shimotoriharuki/2024_robotracer/2024_robotracer_control_design/servo_gain.txt

-30.8843942783021,-3.27677844337711,-0.201098294451269,-0.307268950808485
