shimotoriharuki/2024_robotracer/2024_robotracer_circuit/main/main.dxf

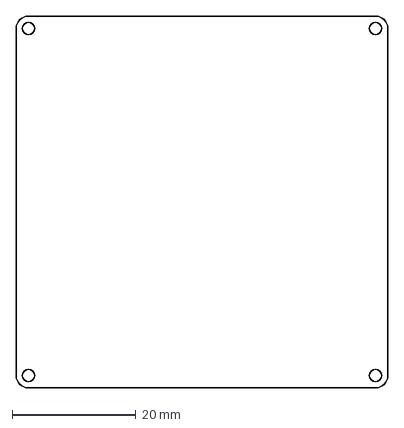
[picture p1: CAD file, 2024-09-07]
2024_robotracer_circuit/main/main.dxf
60.0 x 60.0 mm
