shimotoriharuki/2024_robotracer/2024_robotracer_circuit/following_sensor/following_sensor.step

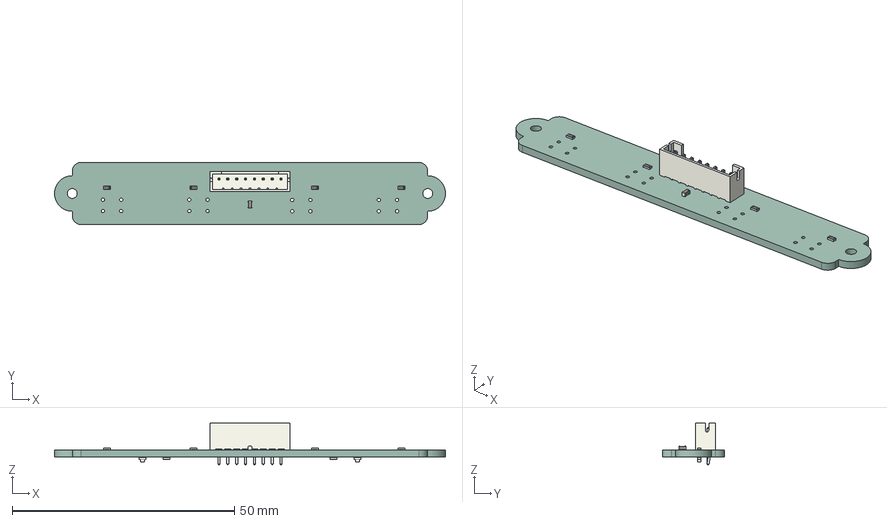
[picture p2: CAD file, 2024-07-03]
2024_robotracer_circuit/following_sensor/following_sensor.step
88.0 x 14.0 x 9.40 mm
C_0603_1608Metric
R_0603_1608Metric x 6
JST_B8B_PH_K
LED_0603_1608Metric x 2
following_sensor_PCB
