shimotoriharuki/2024_robotracer/2024_robotracer_circuit/sd_card/sd_card.step

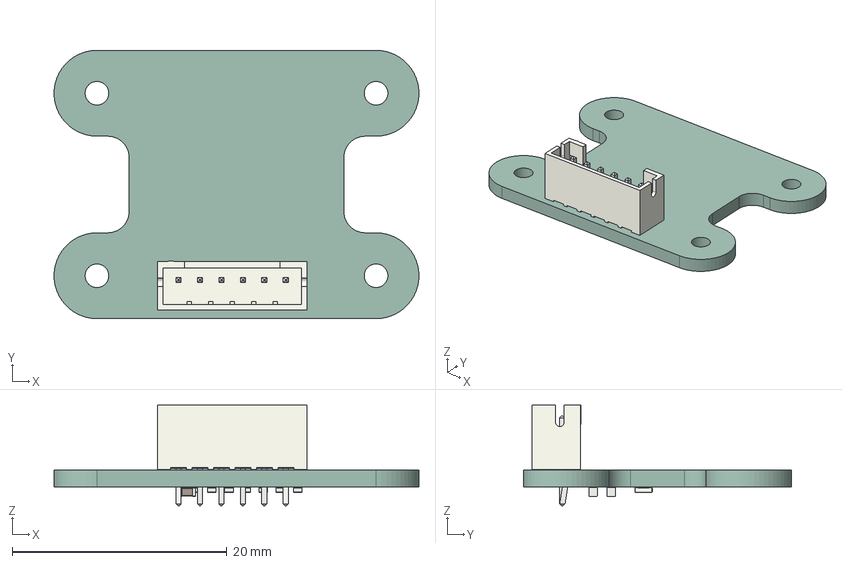
[picture p3: CAD file, 2024-07-03]
2024_robotracer_circuit/sd_card/sd_card.step
34.0 x 25.0 x 9.40 mm
JST_B6B_PH_K
R_0603_1608Metric x 7
C_0603_1608Metric x 2
sd_card_PCB
