shimotoriharuki/2024_robotracer/2024_robotracer_circuit/side_sensor/side_sensor.step

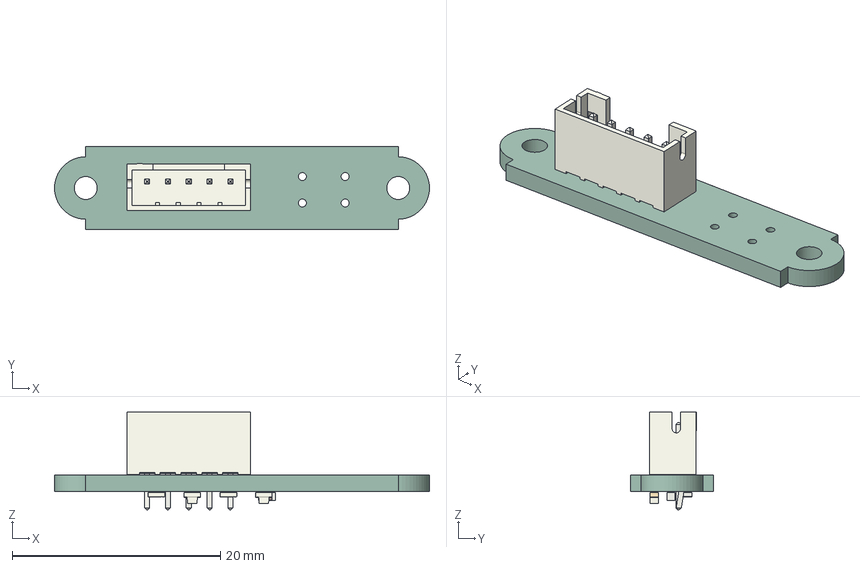
[picture p4: CAD file, 2024-07-03]
2024_robotracer_circuit/side_sensor/side_sensor.step
36.0 x 8.00 x 9.40 mm
JST_B5B_PH_K
R_0603_1608Metric x 3
C_0603_1608Metric
LED_0603_1608Metric x 2
side_sensor_PCB
