shimotoriharuki/2024_robotracer/2024_robotracer_mecha/3d_print_data/chassis2 v21.3mf

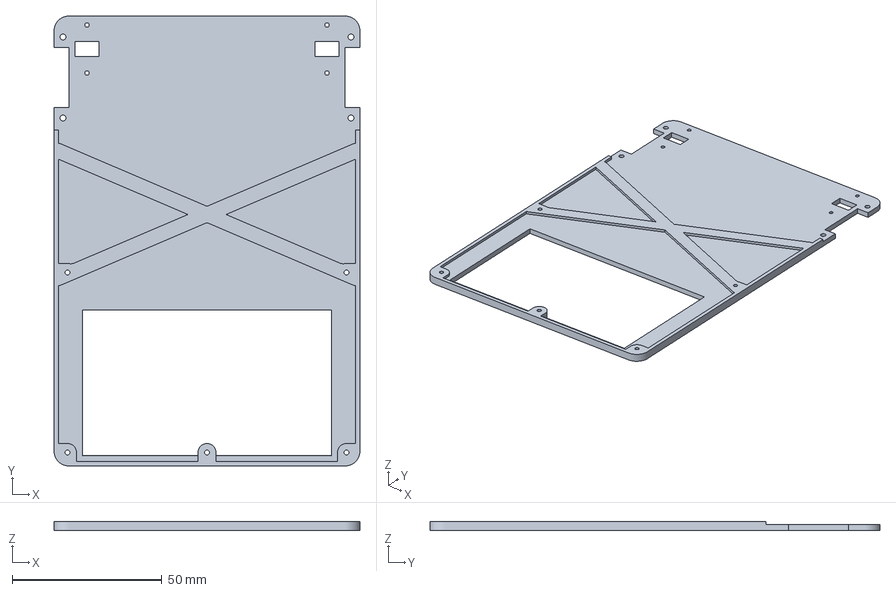
[picture p5: CAD file, 2024-07-13]
2024_robotracer_mecha/3d_print_data/chassis2 v21.3mf
102.0 x 150.0 x 3.00 mm
