shimotoriharuki/2024_robotracer/2024_robotracer_mecha/motor_mount v37.step

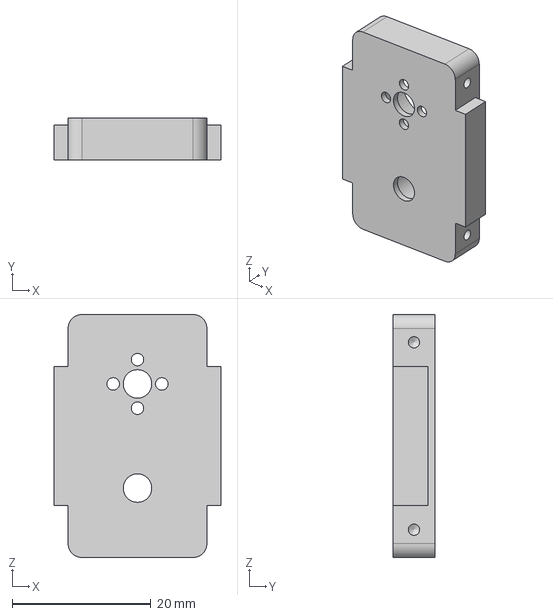
[picture p6: CAD file, 2024-09-07]
2024_robotracer_mecha/motor_mount v37.step
24.0 x 6.00 x 35.0 mm
