shimotoriharuki/2024_robotracer/2024_robotracer_mecha/3d_print_data/sensor_cover v4.3mf

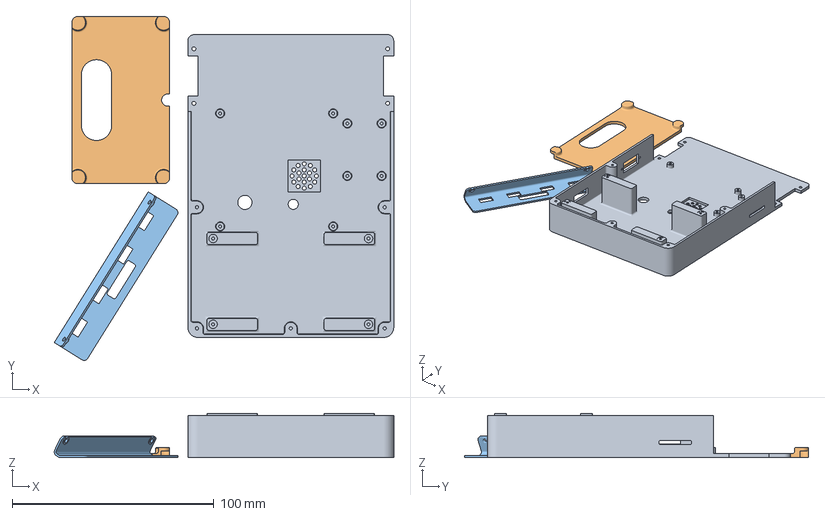
[picture p7: CAD file, 2024-07-13]
2024_robotracer_mecha/3d_print_data/sensor_cover v4.3mf
168.2 x 170.4 x 22.0 mm
chassis v33.step
battery_cover v20.step
sensor_cover v4.step
