shimotoriharuki/2024_robotracer/2024_robotracer_mecha/sensor_mount2 v6(ミラー).step

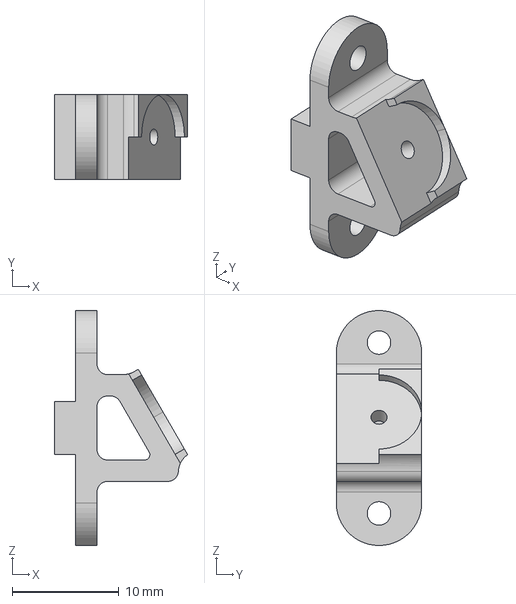
[picture p8: CAD file, 2024-09-07]
2024_robotracer_mecha/sensor_mount2 v6(ミラー).step
12.5 x 8.00 x 22.0 mm
