shimotoriharuki/2024_robotracer/2024_robotracer_mecha/3d_print_data/bearing_spacer v4.3mf

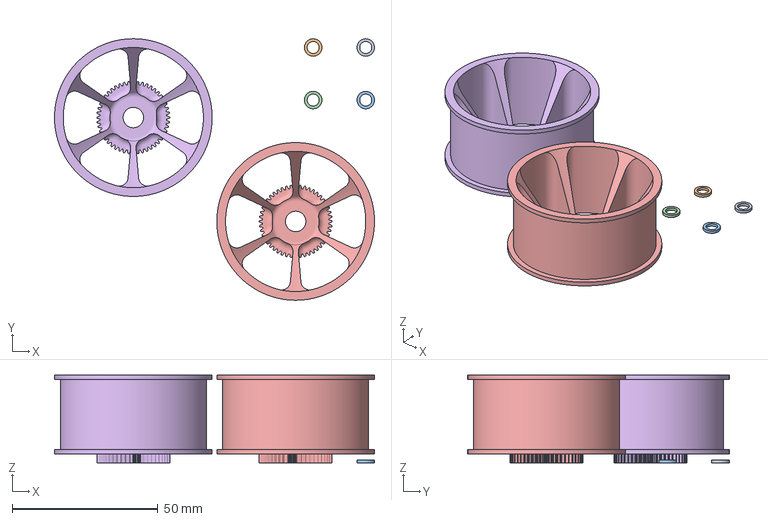
[picture p9: CAD file, 2024-07-13]
2024_robotracer_mecha/3d_print_data/bearing_spacer v4.3mf
109.6 x 89.6 x 30.0 mm
bearing_spacer v4.step x 4
wheel v11.step x 2
