shimotoriharuki/2024_robotracer/2024_robotracer_mecha/battery_cover v20.step

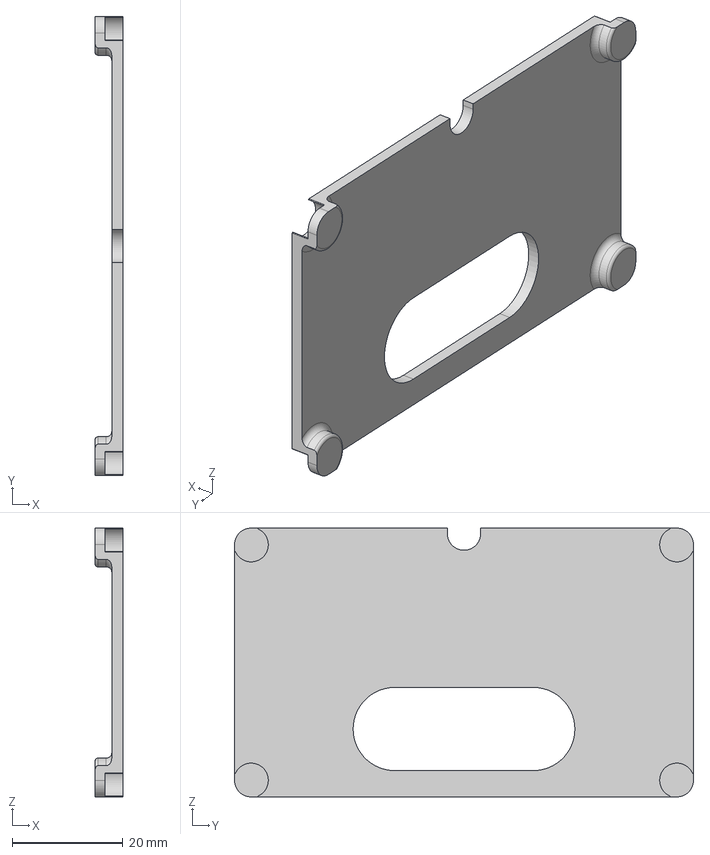
[picture p10: CAD file, 2024-09-07]
2024_robotracer_mecha/battery_cover v20.step
5.00 x 82.8 x 48.5 mm
