shimotoriharuki/2024_robotracer/2024_robotracer_mecha/3d_print_data/motor_mount v30.3mf

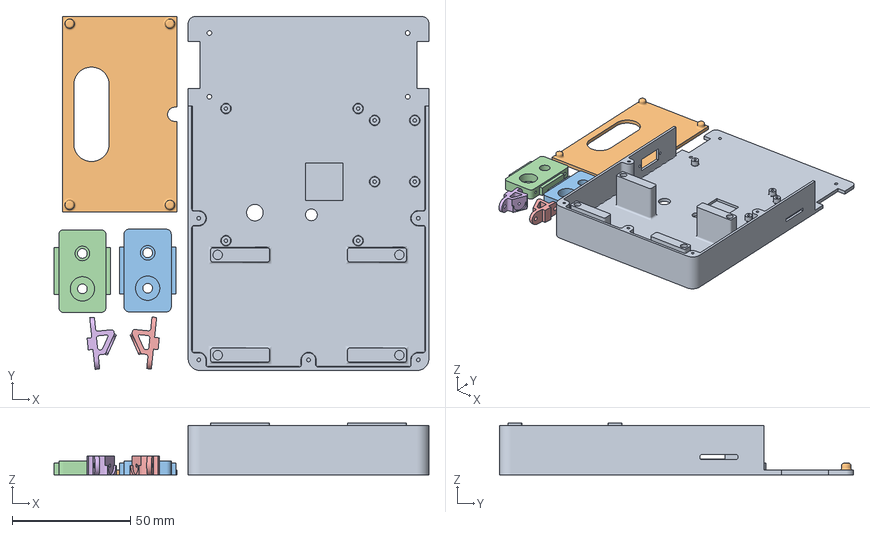
[picture p11: CAD file, 2024-07-13]
2024_robotracer_mecha/3d_print_data/motor_mount v30.3mf
158.8 x 150.0 x 22.0 mm
chassis v31.step
battery_cover v19.step
motor_mount v30.step x 2
sensor_mount2 v6(ミラー).step
sensor_mount2 v8.step
