shimotoriharuki/2024_robotracer/2024_robotracer_mecha/gear_t12_m0.5 v4.step

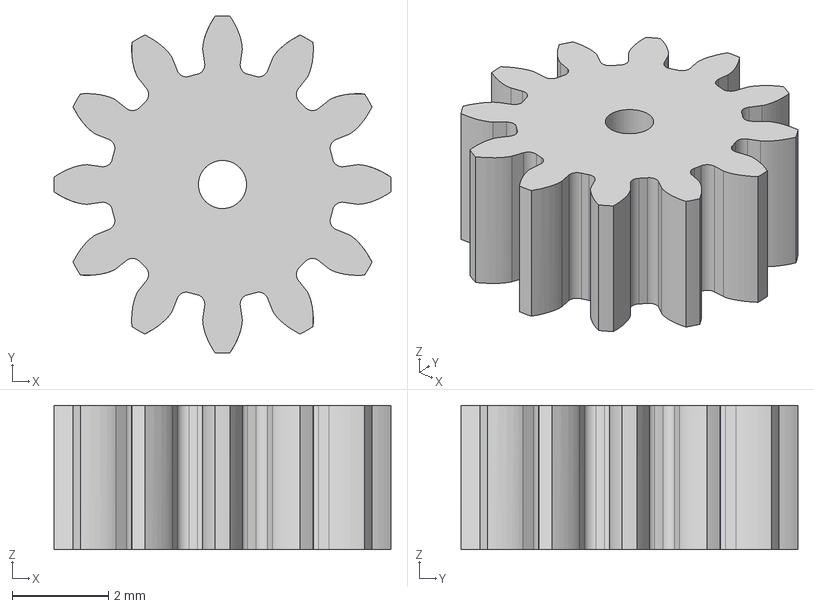
[picture p12: CAD file, 2024-09-07]
2024_robotracer_mecha/gear_t12_m0.5 v4.step
7.00 x 7.00 x 3.00 mm
