shimotoriharuki/2024_robotracer/2024_robotracer_mecha/circuit_spacer v2.step

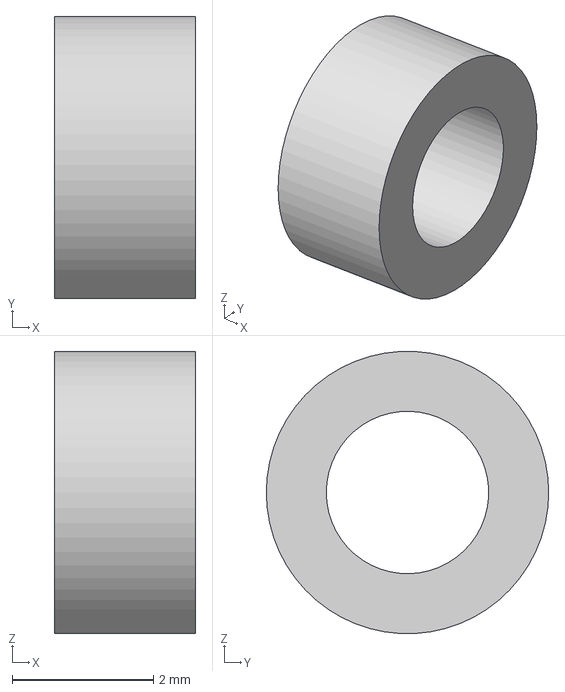
[picture p13: CAD file, 2024-09-07]
2024_robotracer_mecha/circuit_spacer v2.step
2.00 x 4.00 x 3.99 mm
