shimotoriharuki/2024_robotracer/2024_robotracer_mecha/chassis2 v23.step

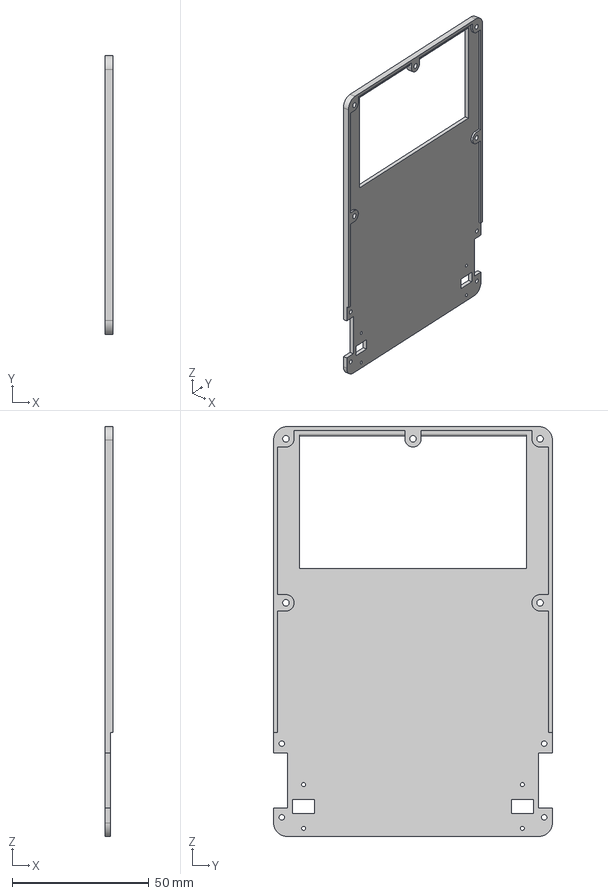
[picture p14: CAD file, 2024-09-07]
2024_robotracer_mecha/chassis2 v23.step
3.00 x 102.0 x 150.0 mm
