shimotoriharuki/2024_robotracer/2024_robotracer_mecha/bearing_spacer v4.step

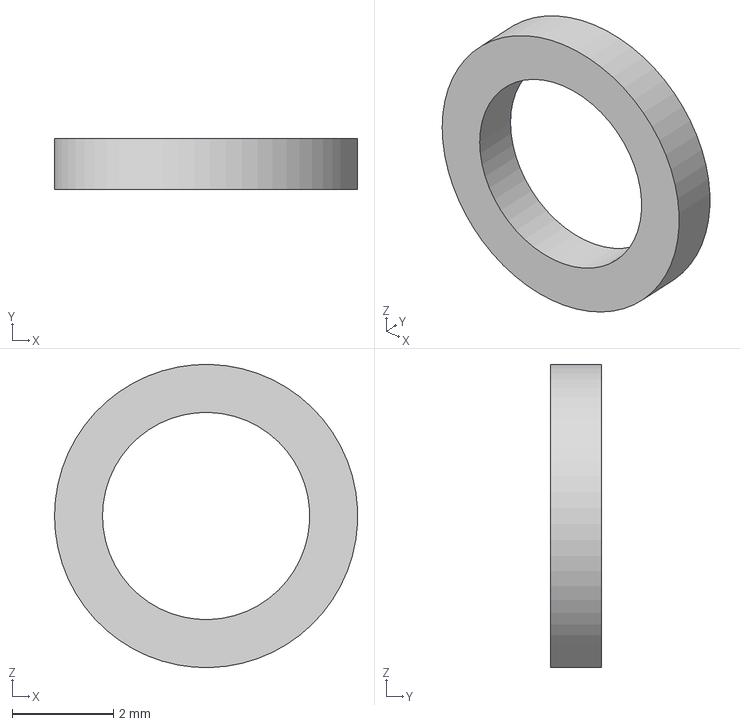
[picture p15: CAD file, 2024-09-07]
2024_robotracer_mecha/bearing_spacer v4.step
6.00 x 1.00 x 6.00 mm
