shimotoriharuki/2024_robotracer/2024_robotracer_mecha/chassis v45.step

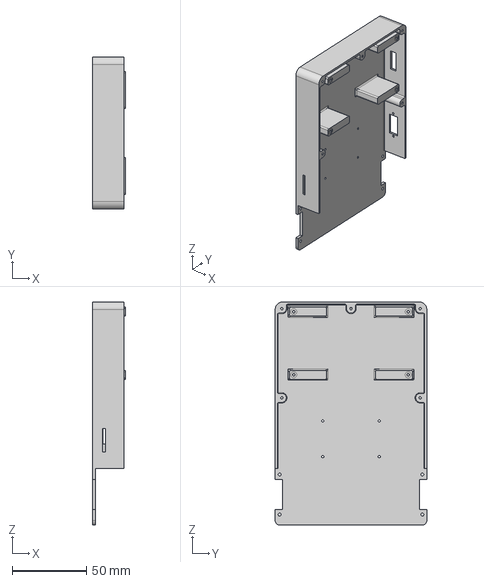
[picture p16: CAD file, 2024-09-07]
2024_robotracer_mecha/chassis v45.step
22.0 x 102.0 x 150.0 mm
