shimotoriharuki/2024_robotracer/2024_robotracer_mecha/sensor_cover v4.step

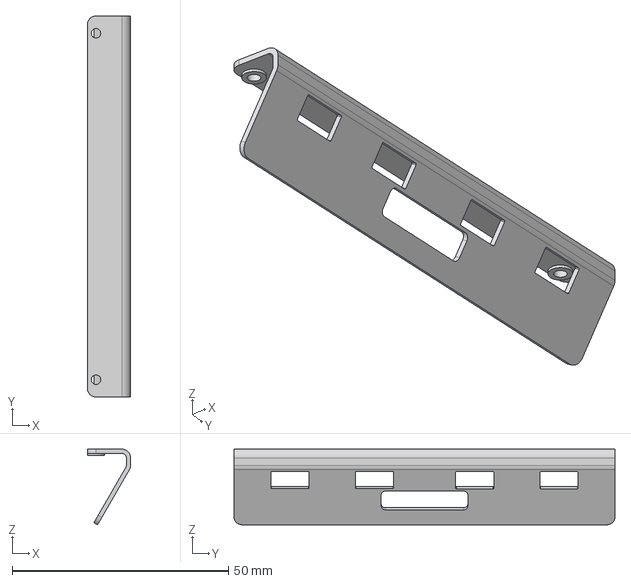
[picture p17: CAD file, 2024-09-07]
2024_robotracer_mecha/sensor_cover v4.step
10.0 x 88.0 x 17.5 mm
