shimotoriharuki/2024_robotracer/(list of files, cad)

Other CAD files:
2024_robotracer_mecha/sensor_mount2 v8.step
