shimotoriharuki/2024_robotracer/2024_robotracer_circuit/side_sensor/side_sensor.kicad_pcb

## KiCad design 2024_robotracer_circuit/side_sensor/side_sensor.kicad_pcb (2024-09-07)

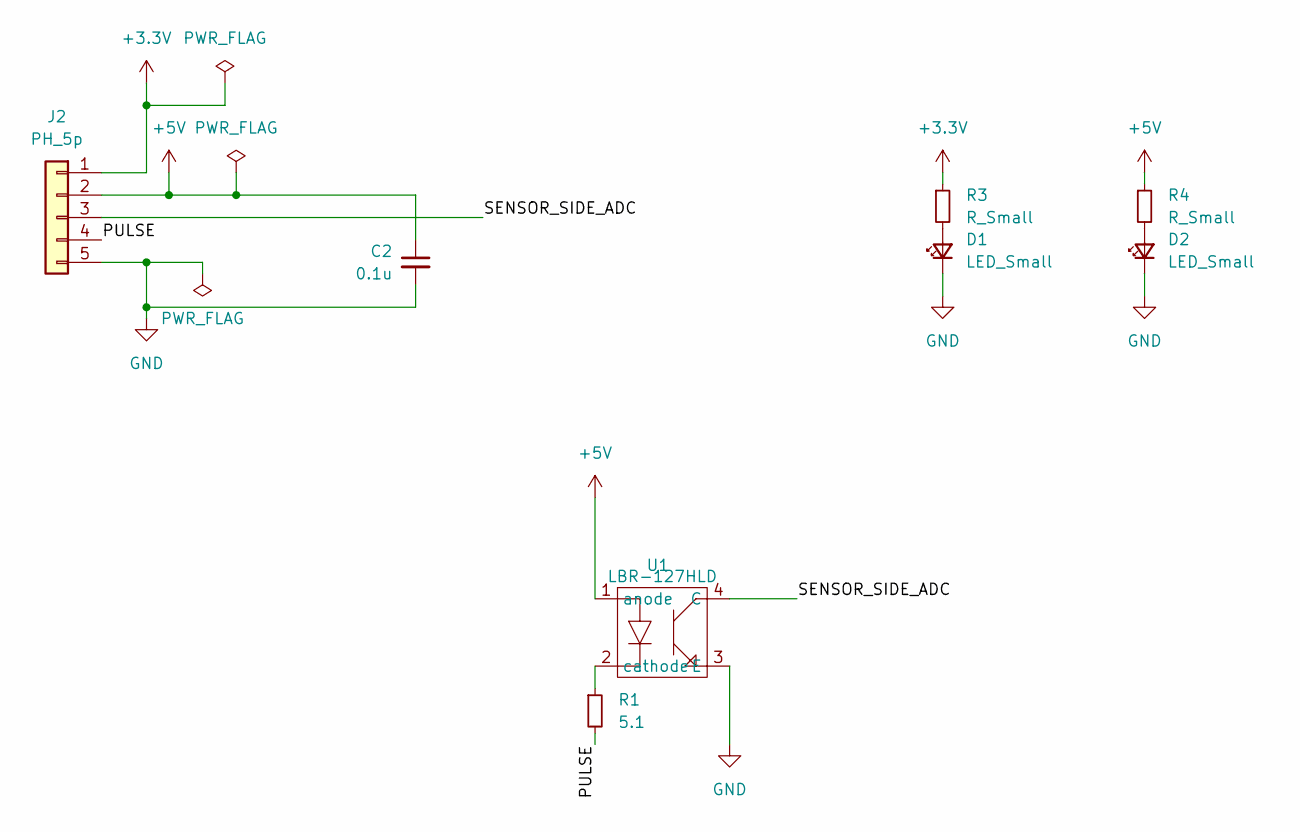
[picture p18: schematic side_sensor.kicad_sch]

Parts:
C2: 0.1u; C_0603_1608Metric_Pad1.08x0.95mm_HandSolder
D1, D2: LED_Small; LED_0603_1608Metric_Pad1.05x0.95mm_HandSolder
J2: PH_5p; JST_PH_B5B-PH-K_1x05_P2.00mm_Vertical
R1: 5.1; R_0603_1608Metric_Pad0.98x0.95mm_HandSolder
R3, R4: R_Small; R_0603_1608Metric_Pad0.98x0.95mm_HandSolder
U1: LBR-127HLD

Connections:
+3.3V: J2.1, R3.1
+5V: C2.1, J2.2, R4.1, U1.1 (anode)
/PULSE: J2.4, R1.2
/SENSOR_SIDE_ADC: J2.3, U1.4 (C)
GND: C2.2, D1.1 (K), D2.1 (K), J2.5, U1.3 (E)
unnamed: D1.2 (A), R3.2
unnamed: D2.2 (A), R4.2
unnamed: R1.1, U1.2 (cathode)

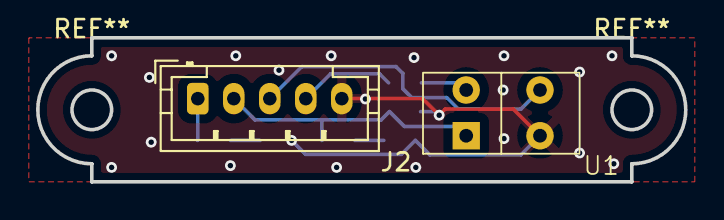
[picture p19: board side_sensor.kicad_pcb from above]

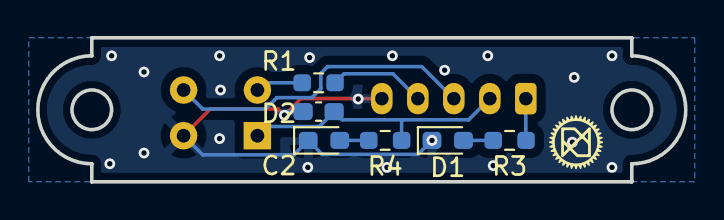
[picture p20: board side_sensor.kicad_pcb from below]

Board: 2 copper layers, 36.0 x 8.0 mm, 8 parts (6 on the bottom side), 8 nets.
