shimotoriharuki/2024_robotracer/2024_robotracer_circuit/following_sensor/following_sensor.kicad_pcb

## KiCad design 2024_robotracer_circuit/following_sensor/following_sensor.kicad_pcb (2024-09-07)

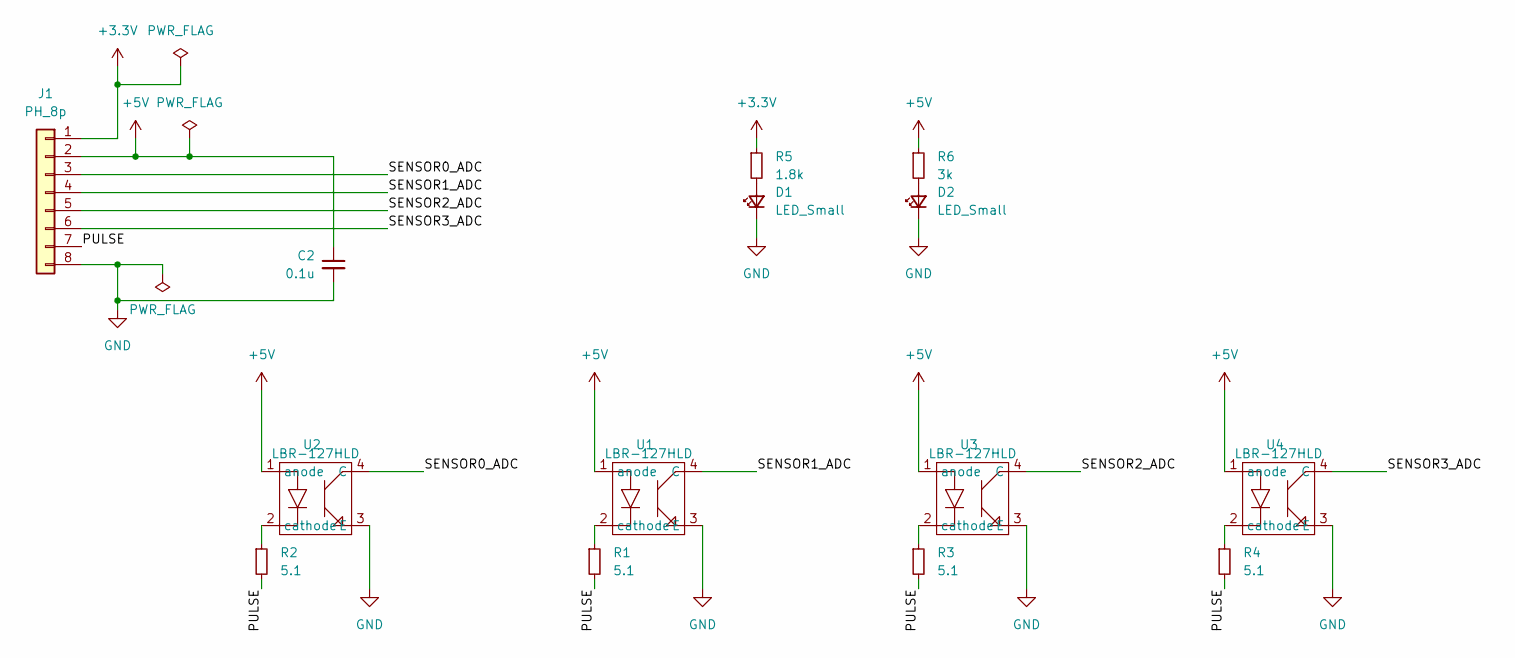
[picture p21: schematic following_sensor.kicad_sch]

Parts:
C2: 0.1u; C_0603_1608Metric_Pad1.08x0.95mm_HandSolder
D1, D2: LED_Small; LED_0603_1608Metric_Pad1.05x0.95mm_HandSolder
J1: PH_8p; JST_PH_B8B-PH-K_1x08_P2.00mm_Vertical
R1, R2, R3, R4: 5.1; R_0603_1608Metric_Pad0.98x0.95mm_HandSolder
R5: 1.8k; R_0603_1608Metric_Pad0.98x0.95mm_HandSolder
R6: 3k; R_0603_1608Metric_Pad0.98x0.95mm_HandSolder
U1, U2, U3, U4: LBR-127HLD

Connections:
+3.3V: J1.1, R5.1
+5V: C2.1, J1.2, R6.1, U1.1 (anode), U2.1 (anode), U3.1 (anode), U4.1 (anode)
/PULSE: J1.7, R1.2, R2.2, R3.2, R4.2
/SENSOR0_ADC: J1.3, U2.4 (C)
/SENSOR1_ADC: J1.4, U1.4 (C)
/SENSOR2_ADC: J1.5, U3.4 (C)
/SENSOR3_ADC: J1.6, U4.4 (C)
GND: C2.2, D1.1 (K), D2.1 (K), J1.8, U1.3 (E), U2.3 (E), U3.3 (E), U4.3 (E)
unnamed: D1.2 (A), R5.2
unnamed: D2.2 (A), R6.2
unnamed: R1.1, U1.2 (cathode)
unnamed: R2.1, U2.2 (cathode)
unnamed: R3.1, U3.2 (cathode)
unnamed: R4.1, U4.2 (cathode)

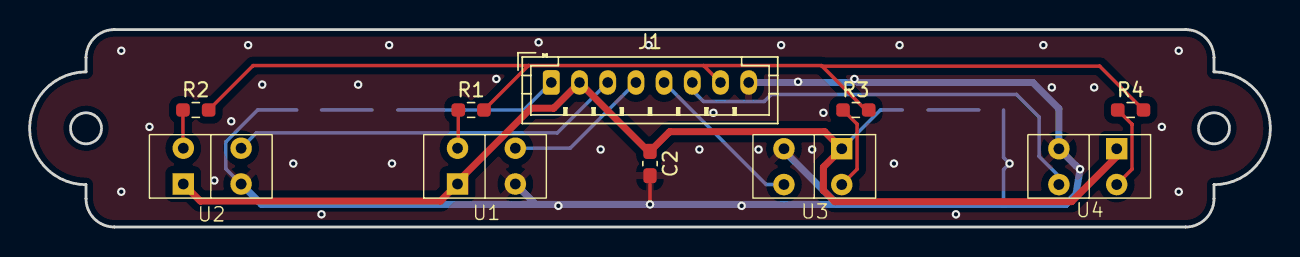
[picture p22: board following_sensor.kicad_pcb from above]

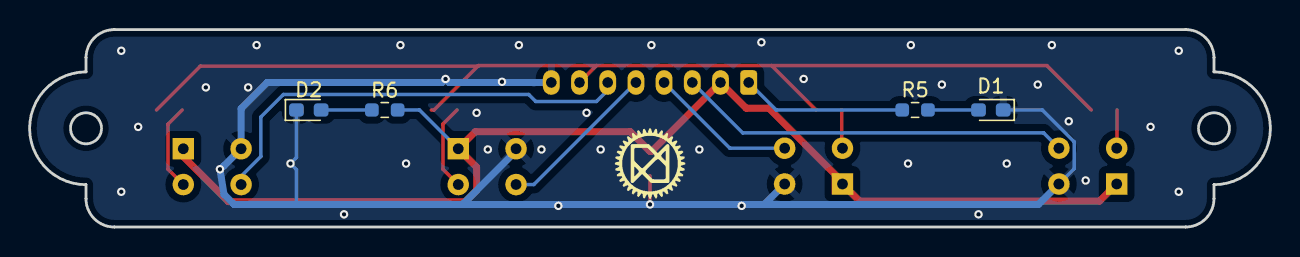
[picture p23: board following_sensor.kicad_pcb from below]

Board: 2 copper layers, 88.0 x 14.0 mm, 14 parts (4 on the bottom side), 14 nets.
