shimotoriharuki/2024_robotracer/2024_robotracer_circuit/sd_card/sd_card.kicad_pcb

## KiCad design 2024_robotracer_circuit/sd_card/sd_card.kicad_pcb (2024-09-07)

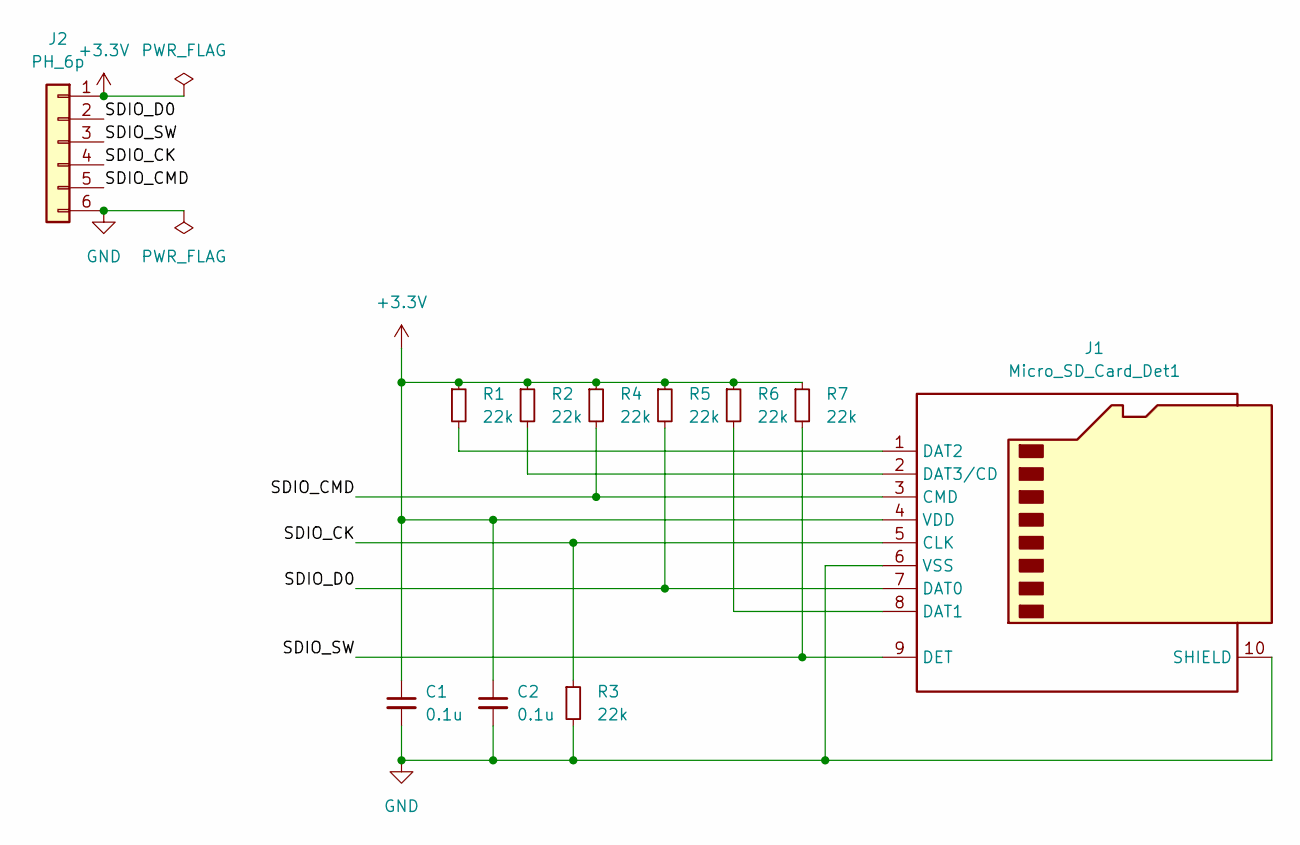
[picture p24: schematic sd_card.kicad_sch]

Parts:
C1, C2: 0.1u; C_0603_1608Metric_Pad1.08x0.95mm_HandSolder
J1: Micro_SD_Card_Det1; microSD_HC_Hirose_DM3AT-SF-PEJM5
J2: PH_6p; JST_PH_B6B-PH-K_1x06_P2.00mm_Vertical
R1, R2, R3, R4, R5, R6, R7: 22k; R_0603_1608Metric_Pad0.98x0.95mm_HandSolder

Connections:
+3.3V: C1.1, C2.1, J1.4 (VDD), J2.1, R1.1, R2.1, R4.1, R5.1, R6.1, R7.1
/SDIO_CK: J1.5 (CLK), J2.4, R3.1
/SDIO_CMD: J1.3 (CMD), J2.5, R4.2
/SDIO_D0: J1.7 (DAT0), J2.2, R5.2
/SDIO_SW: J1.9 (DET), J2.3, R7.2
GND: C1.2, C2.2, J1.6 (VSS), J1.10 (SHIELD), J2.6, R3.2
unnamed: J1.8 (DAT1), R6.2
unnamed: J1.1 (DAT2), R1.2
unnamed: J1.2 (DAT3/CD), R2.2

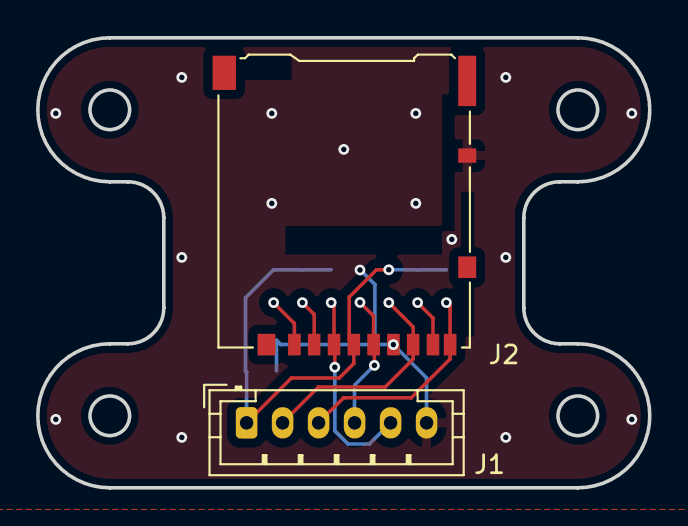
[picture p25: board sd_card.kicad_pcb from above]

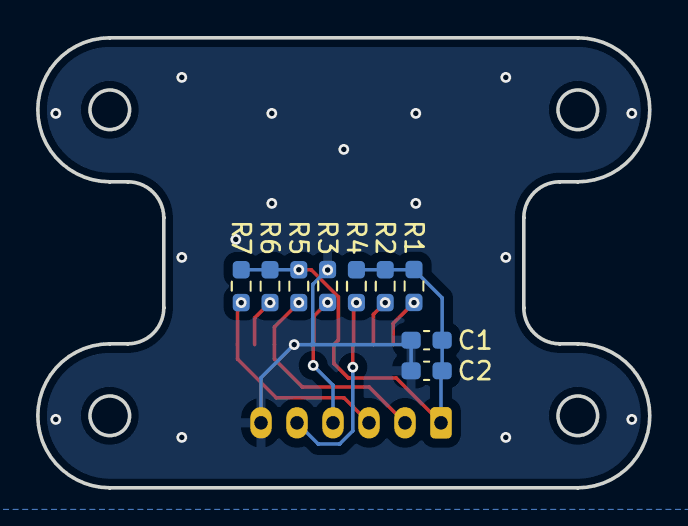
[picture p26: board sd_card.kicad_pcb from below]

Board: 2 copper layers, 34.0 x 25.0 mm, 11 parts (9 on the bottom side), 9 nets.
