shimotoriharuki/2024_robotracer/2024_robotracer_circuit/led/led.kicad_pcb

## KiCad design 2024_robotracer_circuit/led/led.kicad_pcb (2024-09-07)

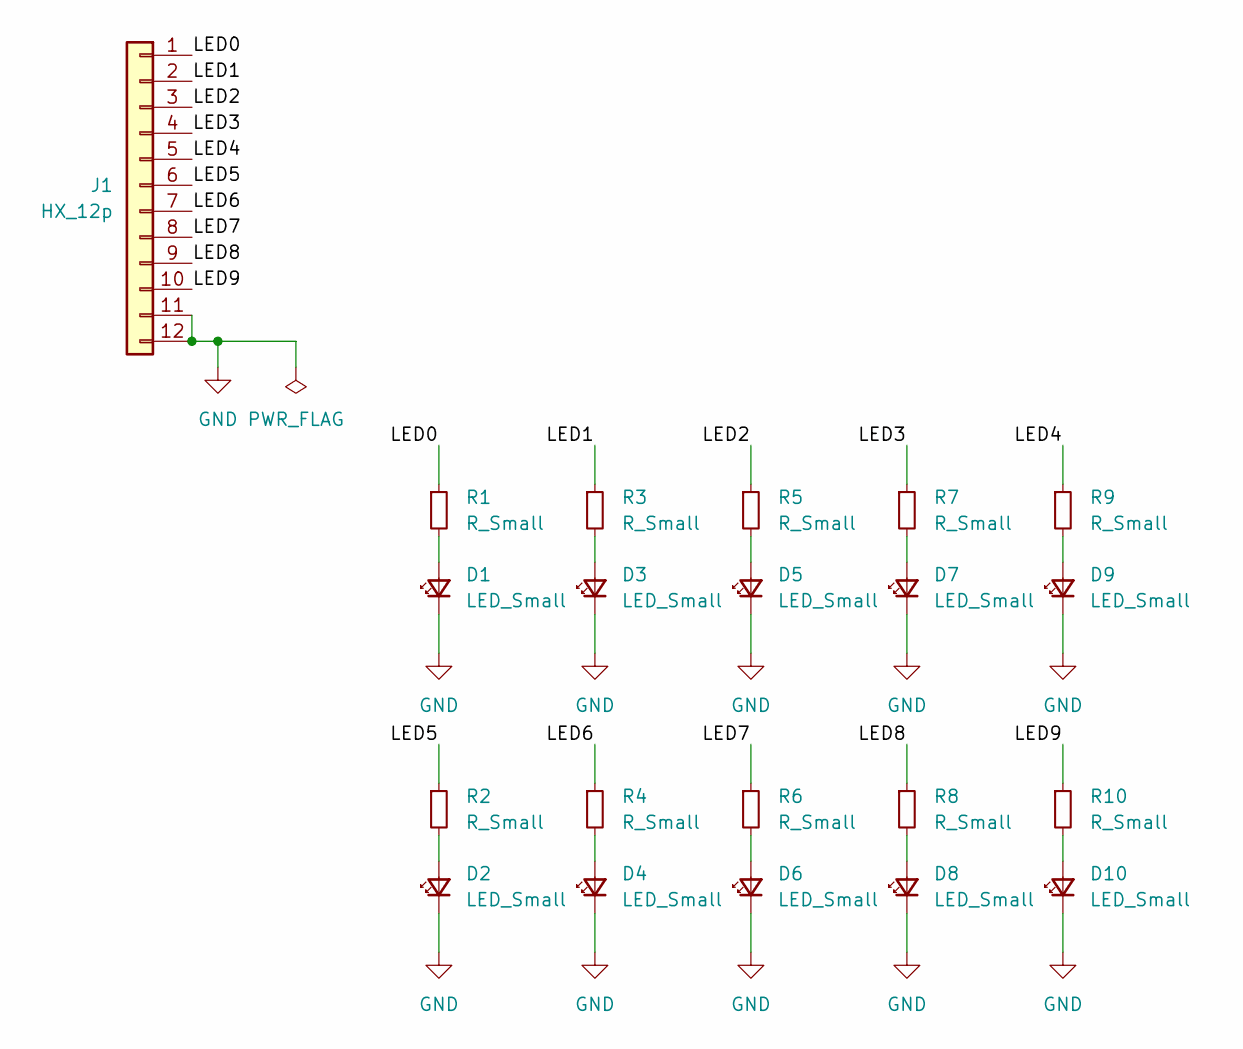
[picture p27: schematic led.kicad_sch]

Parts:
D1, D2, D3, D4, D5, D6, D7, D8, D9, D10: LED_Small; LED_0603_1608Metric_Pad1.05x0.95mm_HandSolder
J1: HX_12p; JST_XH_B12B-XH-A_1x12_P2.50mm_Vertical
R1, R2, R3, R4, R5, R6, R7, R8, R9, R10: R_Small; R_0603_1608Metric_Pad0.98x0.95mm_HandSolder

Connections:
/LED0: J1.1, R1.1
/LED1: J1.2, R3.1
/LED2: J1.3, R5.1
/LED3: J1.4, R7.1
/LED4: J1.5, R9.1
/LED5: J1.6, R2.1
/LED6: J1.7, R4.1
/LED7: J1.8, R6.1
/LED8: J1.9, R8.1
/LED9: J1.10, R10.1
GND: D1.1 (K), D2.1 (K), D3.1 (K), D4.1 (K), D5.1 (K), D6.1 (K), D7.1 (K), D8.1 (K), D9.1 (K), D10.1 (K), J1.11, J1.12
unnamed: D1.2 (A), R1.2
unnamed: D2.2 (A), R2.2
unnamed: D3.2 (A), R3.2
unnamed: D4.2 (A), R4.2
unnamed: D5.2 (A), R5.2
unnamed: D6.2 (A), R6.2
unnamed: D7.2 (A), R7.2
unnamed: D8.2 (A), R8.2
unnamed: D9.2 (A), R9.2
unnamed: D10.2 (A), R10.2

Board: 2 copper layers, 21 parts (0 on the bottom side), 21 nets, no tracks yet.
