shimotoriharuki/2024_robotracer/2024_robotracer_code/Core/Src/main.c

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
/* Includes ------------------------------------------------------------------*/
#include "main.h"
#include "fatfs.h"

ADC_HandleTypeDef hadc1;

I2C_HandleTypeDef hi2c1;
I2C_HandleTypeDef hi2c2;

SD_HandleTypeDef hsd;

SPI_HandleTypeDef hspi2;

TIM_HandleTypeDef htim1;
TIM_HandleTypeDef htim3;
TIM_HandleTypeDef htim4;
TIM_HandleTypeDef htim6;
TIM_HandleTypeDef htim7;
TIM_HandleTypeDef htim8;
TIM_HandleTypeDef htim10;
TIM_HandleTypeDef htim11;
TIM_HandleTypeDef htim12;
TIM_HandleTypeDef htim13;
TIM_HandleTypeDef htim14;

UART_HandleTypeDef huart3;

/* USER CODE BEGIN PV */
uint16_t tim6_cnt;
uint16_t tim7_cnt;

int16_t mon_i;

/* USER CODE END PV */

void SystemClock_Config(void);
static void MX_GPIO_Init(void);
static void MX_ADC1_Init(void);
static void MX_I2C1_Init(void);
static void MX_I2C2_Init(void);
static void MX_SDIO_SD_Init(void);
static void MX_TIM1_Init(void);
static void MX_TIM3_Init(void);
static void MX_TIM4_Init(void);
static void MX_TIM6_Init(void);
static void MX_TIM7_Init(void);
static void MX_TIM10_Init(void);
static void MX_TIM11_Init(void);
static void MX_TIM12_Init(void);
static void MX_TIM13_Init(void);
static void MX_TIM14_Init(void);
static void MX_SPI2_Init(void);
static void MX_USART3_UART_Init(void);
static void MX_TIM8_Init(void);
/* USER CODE BEGIN 0 */

void HAL_TIM_PeriodElapsedCallback(TIM_HandleTypeDef *htim)
{
	if(htim->Instance == TIM6){
       tim6_cnt++;
       if(tim6_cnt >= 10000) tim6_cnt = 0;
   }
   if(htim->Instance == TIM7){
	   tim7_cnt++;
	   if(tim7_cnt >= 10000) tim7_cnt = 0;
   }
}

/* USER CODE END 0 */

/**
  * @brief  The application entry point.
  * @retval int
  */
int main(void)
{
  /* MCU Configuration--------------------------------------------------------*/

  /* Reset of all peripherals, Initializes the Flash interface and the Systick. */
  HAL_Init();

  /* Configure the system clock */
  SystemClock_Config();

  /* Initialize all configured peripherals */
  MX_GPIO_Init();
  MX_ADC1_Init();
  MX_I2C1_Init();
  MX_I2C2_Init();
  MX_SDIO_SD_Init();
  MX_TIM1_Init();
  MX_TIM3_Init();
  MX_TIM4_Init();
  MX_TIM6_Init();
  MX_TIM7_Init();
  MX_FATFS_Init();
  MX_TIM10_Init();
  MX_TIM11_Init();
  MX_TIM12_Init();
  MX_TIM13_Init();
  MX_TIM14_Init();
  MX_SPI2_Init();
  MX_USART3_UART_Init();
  MX_TIM8_Init();
  /* USER CODE BEGIN 2 */
  HAL_TIM_Base_Start_IT(&htim6);
  HAL_TIM_Base_Start_IT(&htim7);
  HAL_TIM_PWM_Start(&htim1, TIM_CHANNEL_1);
  HAL_TIM_PWM_Start(&htim1, TIM_CHANNEL_3);
  //HAL_TIM_PWM_Start(&htim1, TIM_CHANNEL_2);
  /* USER CODE END 2 */

  /* Infinite loop */
  /* USER CODE BEGIN WHILE */
  while (1)
  {
	  //__HAL_TIM_SET_COMPARE(&htim1, TIM_CHANNEL_2, 0); //A
	  /*
	  HAL_GPIO_WritePin(GPIOA, GPIO_PIN_9, GPIO_PIN_RESET);
	  for(mon_i = 500; mon_i < 1000; mon_i++){
		  __HAL_TIM_SET_COMPARE(&htim1, TIM_CHANNEL_1, mon_i); //B
		  HAL_Delay(1);
	  }
	  */

	  HAL_GPIO_WritePin(GPIOA, GPIO_PIN_9, GPIO_PIN_SET);
	  HAL_GPIO_WritePin(GPIOA, GPIO_PIN_11, GPIO_PIN_SET);
	  for(mon_i = 4000; mon_i < 8000; mon_i++){
		  __HAL_TIM_SET_COMPARE(&htim1, TIM_CHANNEL_1, mon_i); //B
		  __HAL_TIM_SET_COMPARE(&htim1, TIM_CHANNEL_3, mon_i); //B
		  HAL_Delay(1);
	  }

	  //__HAL_TIM_SET_COMPARE(&htim1, TIM_CHANNEL_2, 3359); //A
	  /*
	  HAL_GPIO_WritePin(GPIOA, GPIO_PIN_9, GPIO_PIN_RESET);
	  __HAL_TIM_SET_COMPARE(&htim1, TIM_CHANNEL_1, 1000); //B
	  HAL_Delay(1000);
	  */
    /* USER CODE END WHILE */

    /* USER CODE BEGIN 3 */
  }
  /* USER CODE END 3 */
}

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
