shimotoriharuki/2024_robotracer/2024_robotracer_code/2024_robotracer_code.ioc

Mcu.UserName=STM32F405RGTx
PA0-WKUP.GPIO_Label=ADC1_IN0_SENSOR0
PA0-WKUP.Signal=ADCx_IN0
PA1.GPIO_Label=ADC1_IN1_SENSOR1
PA1.Signal=ADCx_IN1
PA10.GPIO_Label=TIM1_CH3_MOTOR2
PA10.Signal=S_TIM1_CH3
PA11.Signal=GPIO_Output
PA12.Signal=GPIO_Output
PA13.Signal=SYS_JTMS-SWDIO
PA14.Signal=SYS_JTCK-SWCLK
PA15.GPIO_Label=GPIO_INPUT_SD
PA15.Signal=GPIO_Input
PA2.GPIO_Label=ADC1_IN2_SENSOR2
PA2.Signal=ADCx_IN2
PA3.GPIO_Label=ADC1_IN3_SENSOR3
PA3.Signal=ADCx_IN3
PA4.GPIO_Label=ADC1_IN4_SENSOR_L
PA4.Signal=ADCx_IN4
PA5.GPIO_Label=ADC1_IN5_SENSOR_R
PA5.Signal=ADCx_IN5
PA6.GPIO_Label=ADC1_IN6_BATT
PA6.Signal=ADCx_IN6
PA7.GPIO_Label=GPIO_INPUT_SW0
PA7.Signal=GPIO_Input
PA8.GPIO_Label=TIM1_CH1_MOTOR1
PA8.Signal=S_TIM1_CH1
PA9.Signal=GPIO_Output
PB0.GPIO_Label=GPIO_INPUT_SW3
PB0.Signal=GPIO_Input
PB1.GPIO_Label=GPIO_INPUT_SW4
PB1.Signal=GPIO_Input
PB10.GPIO_Label=I2C2_SCL_LCD
PB10.Signal=I2C2_SCL
PB11.GPIO_Label=I2C2_SDA_LCD
PB11.Signal=I2C2_SDA
PB12.Signal=GPIO_Output
PB13.GPIO_Label=SPI2_SCK_GP
PB13.Signal=SPI2_SCK
PB14.GPIO_Label=TIM12_CH1_BZ
PB14.Signal=S_TIM12_CH1
PB15.GPIO_Label=TIM12_CH2_GP
PB15.Signal=S_TIM12_CH2
PB2.Signal=GPIO_Output
PB3.Signal=SYS_JTDO-SWO
PB4.Signal=GPIO_Output
PB5.Signal=GPIO_Output
PB6.GPIO_Label=TIM4_CH1_ENC1
PB6.Signal=S_TIM4_CH1
PB7.GPIO_Label=TIM4_CH2_ENC1
PB7.Signal=S_TIM4_CH2
PB8.GPIO_Label=I2C1_SCL_IMU
PB8.Signal=I2C1_SCL
PB9.GPIO_Label=I2C1_SDA_IMU
PB9.Signal=I2C1_SDA
PC0.Signal=GPIO_Output
PC1.Signal=GPIO_Output
PC10.Signal=USART3_TX
PC11.Signal=USART3_RX
PC12.Signal=SDIO_CK
PC13-ANTI_TAMP.Signal=GPIO_Output
PC14-OSC32_IN.Signal=GPIO_Output
PC15-OSC32_OUT.Signal=GPIO_Output
PC2.GPIO_Label=SPI2_MISO_GP
PC2.Signal=SPI2_MISO
PC3.GPIO_Label=SPI2_MOSI_GP
PC3.Signal=SPI2_MOSI
PC4.GPIO_Label=GPIO__INPUT_SW1
PC4.Signal=GPIO_Input
PC5.GPIO_Label=GPIO_INPUT_SW2
PC5.Signal=GPIO_Input
PC6.GPIO_Label=TIM3_CH1_ENC2
PC6.Signal=S_TIM3_CH1
PC7.GPIO_Label=TIM3_CH2_ENC2
PC7.Signal=S_TIM3_CH2
PC8.Signal=SDIO_D0
PC9.GPIO_Label=TIM8_CH4_SENSOR_PWM
PC9.Signal=S_TIM8_CH4
PD2.Signal=SDIO_CMD
PH0-OSC_IN.Signal=RCC_OSC_IN
PH1-OSC_OUT.Signal=RCC_OSC_OUT
