shimotoriharuki/2024_robotracer/reRo_robotrace_board_code/Core/Inc/getEquationOfStateParameters.h

/*
 * Sponsored License - for use in support of a program or activity
 * sponsored by MathWorks.  Not for government, commercial or other
 * non-sponsored organizational use.
 * File: getEquationOfStateParameters.h
 *
 * MATLAB Coder version            : 24.1
 * C/C++ source code generated on  : 2024/08/04 17:01:01
 */

#ifndef GETEQUATIONOFSTATEPARAMETERS_H
#define GETEQUATIONOFSTATEPARAMETERS_H

/* Include Files */
#include "rtwtypes.h"
#include <stddef.h>
#include <stdlib.h>

#ifdef __cplusplus
extern "C" {
#endif

/* Function Declarations */
extern void getEquationOfStateParameters(double m_w, double m_p, double r_w,
                                         double r_p, double J_w, double J_p,
                                         double J_m, double g, double n,
                                         double kt, double kn, double R,
                                         double A[16], double B[4],
                                         double C[4]);

#ifdef __cplusplus
}
#endif

#endif
/*
 * File trailer for getEquationOfStateParameters.h
 *
 * [EOF]
 */
