shimotoriharuki/2024_robotracer/(commit log)

2024-06-08 回路すすめた
    [main.kicad_sch]
2024-06-08 コード追加
2024-06-08 ディレクトリ名変更
    [main.kicad_pcb, main.kicad_sch]
2024-06-12 ピン割り当て
    [main.kicad_sch]
2024-06-13 デザインルールOK
    [main.kicad_sch]
2024-06-13 ピン割り当て変更
2024-06-14 フットプリント割り当て中
    [main.kicad_pcb, main.kicad_sch]
2024-06-17 とちゅう
    [main.kicad_sch]
2024-06-21 フットプリント割り当ておわり
    [main.kicad_pcb, main.kicad_sch]
2024-06-21 基板わけた
    [following_sensor.kicad_pcb, following_sensor.kicad_sch, main.kicad_pcb, main.kicad_sch, side_sensor.kicad_pcb, side_sensor.kicad_sch]
2024-06-21 SDカード分けた
    [main.dxf, main.kicad_pcb, main.kicad_sch, sd_card.kicad_pcb, sd_card.kicad_sch]
2024-06-21 パターン引き中
    [main.kicad_pcb, main.kicad_sch]
2024-06-26 LED基板分けた
    [led.kicad_pcb, led.kicad_sch, main.kicad_pcb, main.kicad_sch]
2024-06-29 配線途中
    [main.kicad_pcb, main.kicad_sch]
2024-06-30 マイコン向き変えたい
    [main.kicad_pcb, main.kicad_sch]
2024-06-30 マイコン回転させる前
    [main.kicad_pcb, main.kicad_sch]
2024-06-30 LEDつながた
    [main.kicad_pcb, main.kicad_sch]
2024-06-30 未配線はなし
    [main.kicad_pcb]
2024-07-01 エラーなし
    [main.kicad_pcb]
2024-07-02 センサー
    [following_sensor.kicad_pcb, following_sensor.kicad_sch, main.kicad_pcb]
2024-07-03 サイドセンサ
    [following_sensor.kicad_pcb, side_sensor.kicad_pcb, side_sensor.kicad_sch]
2024-07-03 製造ファイル生成
    [bom.csv, designators.csv, following_sensor.kicad_pcb, main.kicad_pcb, positions.csv, side_sensor.kicad_pcb]
2024-07-03 sdカード
    [bom.csv, designators.csv, positions.csv, sd_card.kicad_pcb, sd_card.kicad_sch]
2024-07-03 STEPエクスポート
    [following_sensor.kicad_pcb, following_sensor.step, main.kicad_pcb, sd_card.kicad_pcb, sd_card.step, side_sensor.step]
2024-07-13 割り込みできたけど周波数ちがそう
2024-07-13 割りこみOK
    [battery_cover v20.step, bearing_spacer v4.3mf, bearing_spacer v4.step, chassis v41.step, chassis2 v21.3mf, chassis2 v23.step, gear_t12_m0.5 v2.step, motor_mount v30.3mf]
2024-07-14 周波数低くしたら発熱おさまった希ガス
    [motor_mount v36.step, motor_mount v37.step]
2024-07-20 旧基板もってきた書き込めた
    [chassis v41.step, chassis v45.step, circuit_spacer v2.step, gear_t12_m0.5 v2.step, gear_t12_m0.5 v3.step]
2024-07-20 IMUフル機能
2024-07-20 加速度角度OK
2024-07-20 各速度での角度と走り出す前の初期化完了
2024-07-20 PIDそれっぽくうごいた
2024-07-21 カルマンフィルタのコード追加
    [gear_t12_m0.5 v3.step, gear_t12_m0.5 v4.step]
2024-07-21 警告なし
2024-07-21 推定角度NAN！！
2024-07-21 値でたけど変
2024-07-22 角度が発散する
2024-07-22 分散を計算
2024-07-22 やはり発進する
2024-07-23 MATLABだと発散しない
2024-07-23 offsetの単位がちがかった。直した
2024-07-23 ジャイロのみと加速度のみと比較してカルマンフィルタは確かによさそう
2024-07-23 PIDでもいい感じになった気がする
2024-07-23 codegenように書き換えた
2024-07-23 コード生成Ok
2024-07-23 ファイル変になったので整理
2024-07-23 状態フィードバック系のコードを移植
2024-07-24 一通り書いたけどxbの振子の角度を計測した値を用いるようにする必要あり
2024-07-25 エンコーダの値おかしい？
2024-07-25 デバッグの画面にある数値がおかしい？
2024-08-01 エンコーダ角速度とかOK
2024-08-01 発振する
2024-08-04 サーボ系をいったんやめる
2024-08-04 シンプルに
2024-08-04 生成したファイルいったん削除
2024-08-04 サーボなしを移植
2024-08-04 ピニオンがゆるゆるだった
2024-08-05 動いてそう。そのばにとどまらない
2024-08-05 サーボ移植
2024-08-05 サーボでも変わらずその場にとどまらん
2024-08-06 減速比修正
2024-08-06 減速比なおしたゲインにした
2024-08-07 エンコーダの符号向きが逆だった説
2024-08-07 ふらｒふらするけど倒立する
2024-08-07 これくらいがいまは限界かも
2024-08-08 デバッグ用無限ループ削除
    [following_sensor.kicad_pcb, following_sensor.kicad_sch]
2024-08-08 前にはすすめそう
2024-08-10 いちおうフェイルセーフつけた
2024-08-10 フェイルセーフOK
2024-08-10 いったんライントレース処理かいた
2024-08-10 トレースと倒立連動してそう
2024-08-10 前進まない
2024-08-10 前進んでる
2024-08-10 target_thetaを0から2piにしてみた
2024-08-10 ゲイン変えてみた
2024-08-10 いったんゆっくりはしる
2024-08-10 まあはしる
2024-09-07 回路を大幅修正
    [battery_cover v20.step, bearing_spacer v4.step, bom.csv, chassis v45.step, chassis2 v23.step, circuit_spacer v2.step, designators.csv, following_sensor.kicad_pcb]
