shimotoriharuki/2024_robotracer/(notices)

Notices in the files:
2024_robotracer_code/Core/Inc/main.h:
Copyright (c) 2024 STMicroelectronics.
All rights reserved.
This software is licensed under terms that can be found in the LICENSE file
